cecat/util-watch/Arduino/hardware/wiring.jpg

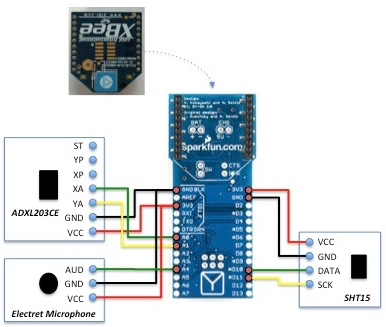
Arduino/hardware/wiring.jpg
