cecat/util-watch/Arduino/README.txt

The hardware folder has details on wiring up sensors on an Arduino.

The uwProductionFeb8 folder has the code that is running on my Arduino,
and has been running non-stop since February 8, 2014.
