cecat/util-watch/(commit log)

2015-12-24 base
    code running on Arduino as of 2015-12-24
2016-01-03 cleaned up error messaging for -v and /var/log/messages
    [uw-Server.py]
